sambilbow/Deck-X/Deck_X/STL_files/Headgear/BoboVR_Headgear_Adaptor/README.md

# BoboVR Headgear Adaptor 
These allow for the use of the BoboVR M2 headgear with the Deck X. 

Designed and shared by Noah Zerkin:
> Adapters for a relatively inexpensive Bobo clone / derivative. Had to cut and grind down the slide receivers on that headgear. Want to make one more tweak tomorrow and will post. Ergonomics aren’t bad, even without the foam forehead pad that’s missing from this one. Adjustability isn’t as smooth or clever as FLZero’s, but there’s actually a little more of it in terms of vertical repositioning, and slides out at least far enough to accommodate my glasses.

<div align="right"><i>
@noazark, August 2022 | Project North Star Discord Server | <a href="https://discord.com/channels/456107915514871828/456857961344532492/1007685576348151900">#3d-printing</a>
</i></div>

## What to print
`BoboAdapterL.stl`, for the left side, then again but flip on the x-axis for the right side.

## What to buy 
BoboVR M2 Plus (model without the battery) [[Amazon]](https://www.amazon.co.uk/dp/B0B2RP1N4F?psc=1&ref=ppx_yo2ov_dt_b_product_details) [[AliExpress]](https://www.aliexpress.com/item/1005002603950456.html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)

## Assembly
1. Add the hex screws provided with the Deck X kit into the adaptors.
2. Connect the adaptors to each side of the headgear 
3. Tighten the new headgear to the optics bracket via the hex screw
4. Adjust fit using adaptor angle and tightness to bring optics bracket closer to the face.

## Photos

| Images | Description |
:----------:|:-------------:
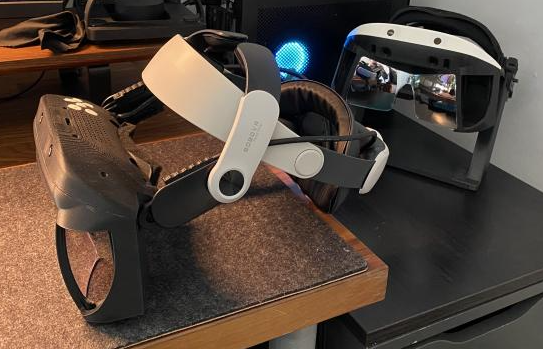
[picture p1: Deck_X/STL_files/Headgear/BoboVR_Headgear_Adaptor/img/bobovr-1.png]
BoboVR Deck X with Bollé Welding Headgear Deck X in the background
 | BoboVR Deck X with <a href="">Bollé Welding Headgear</a> Deck X in the background on an original calibration stand
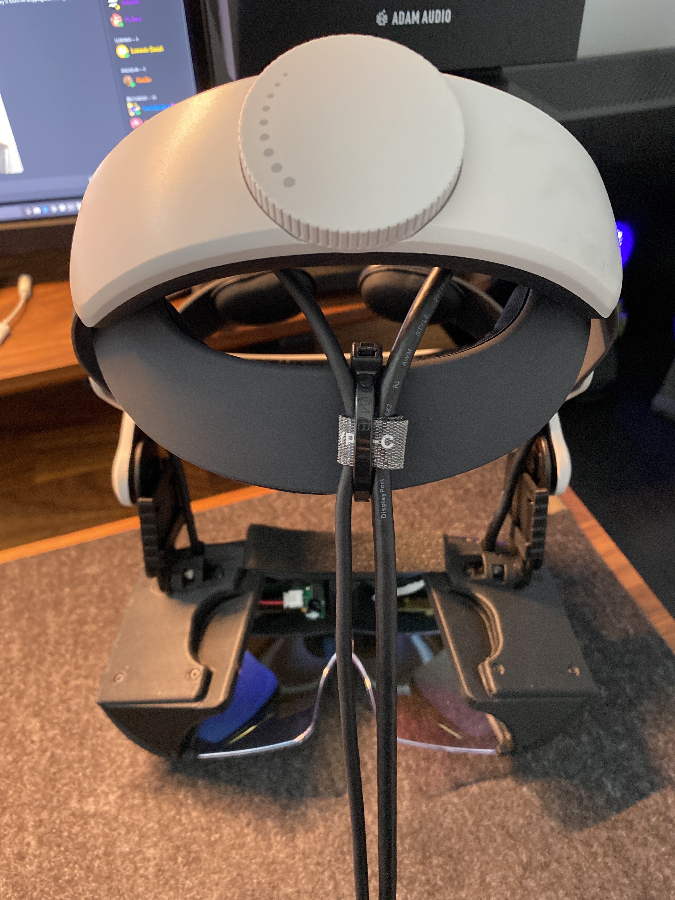
[picture p2: Deck_X/STL_files/Headgear/BoboVR_Headgear_Adaptor/img/bobovr-2.png]
Cable view of the BoboVR with Velcro & zip tie solution
 | Cable view of the BoboVR with Velcro & zip tie solution
