sambilbow/Deck-X/Deck_X/STL_files/Headgear/BoboVR_Headgear_Adaptor/BoboAdapterL.stp

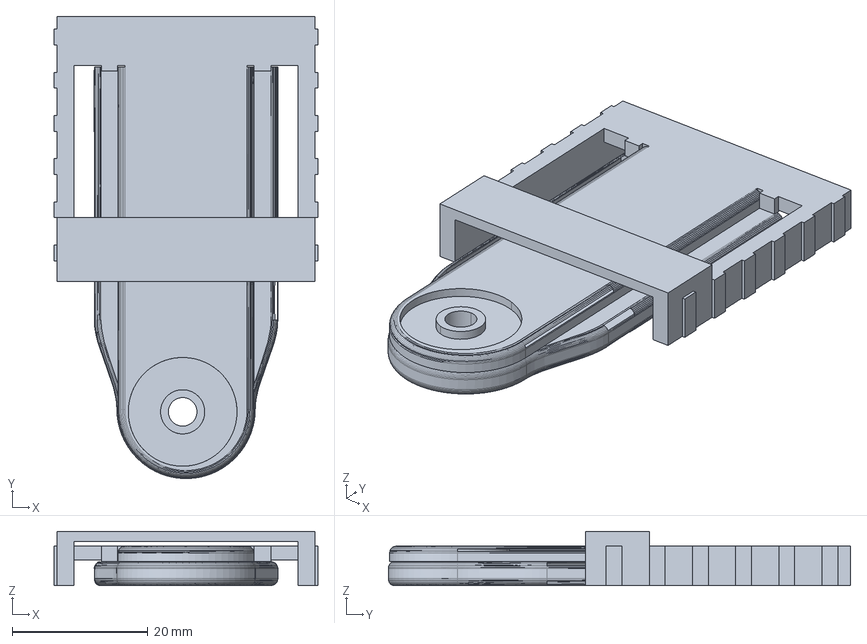
[picture p9: CAD file, 2023-05-10]
Deck_X/STL_files/Headgear/BoboVR_Headgear_Adaptor/BoboAdapterL.stp
38.8 x 68.0 x 7.96 mm
