sambilbow/Deck-X/Deck_X/STL_files/Headgear/Welding_Headgear_Adaptor/headgear_rail_attachment.stl

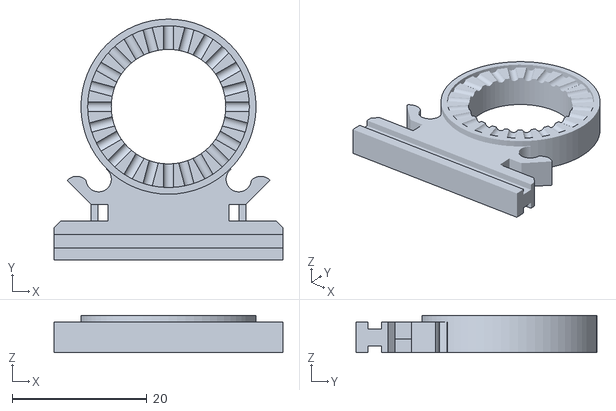
[picture p10: CAD file, 2021-10-27]
Deck_X/STL_files/Headgear/Welding_Headgear_Adaptor/headgear_rail_attachment.stl
34.0 x 35.8 x 5.50
