sambilbow/Deck-X/Deck_X/STL_files/Headgear/Welding_Headgear_Adaptor/headgear_spacer.stl

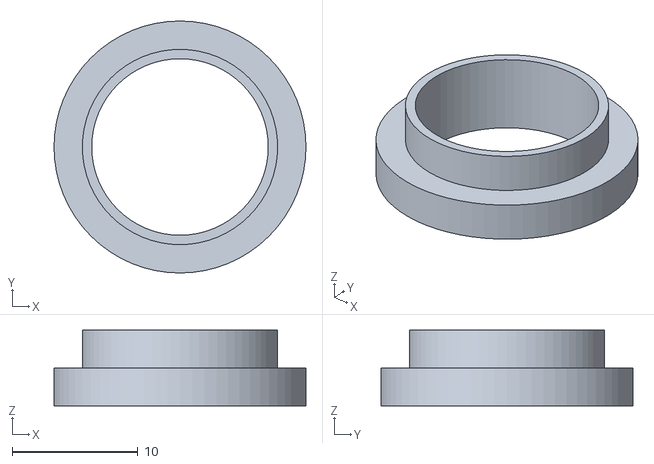
[picture p11: CAD file, 2021-10-27]
Deck_X/STL_files/Headgear/Welding_Headgear_Adaptor/headgear_spacer.stl
20.0 x 20.0 x 6.00
