sambilbow/Deck-X/Deck_X/STL_files/Headgear/Welding_Headgear_Adaptor/headgear_mount_L.stl

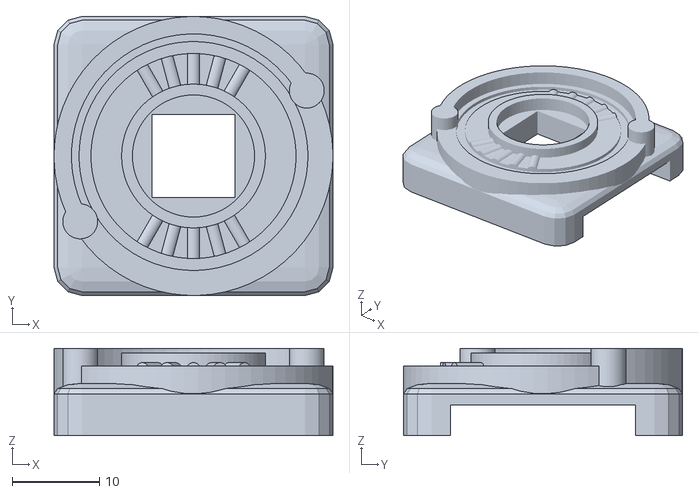
[picture p12: CAD file, 2021-10-27]
Deck_X/STL_files/Headgear/Welding_Headgear_Adaptor/headgear_mount_L.stl
32.0 x 32.0 x 10.0
