sambilbow/Deck-X/Deck_X/STL_files/Headgear/Welding_Headgear_Adaptor/headgear_brake_housing_L.stl

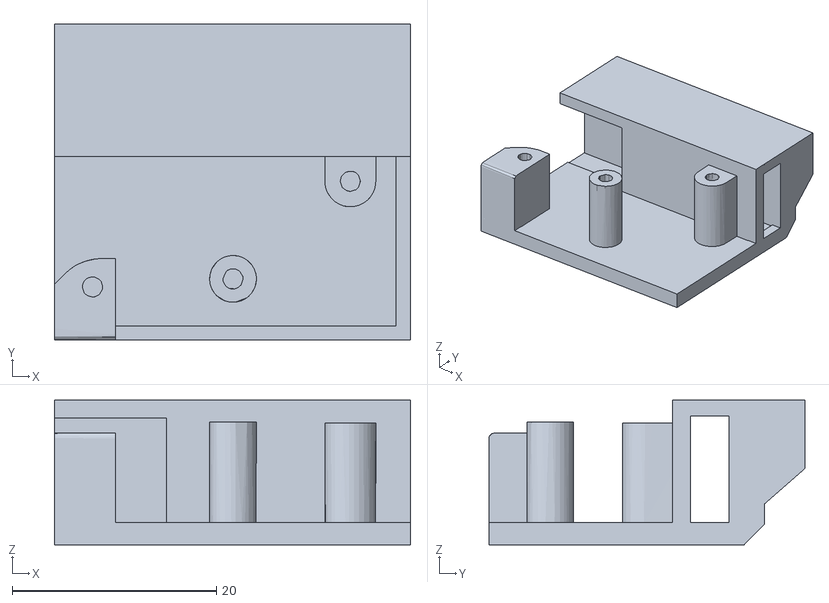
[picture p13: CAD file, 2021-10-27]
Deck_X/STL_files/Headgear/Welding_Headgear_Adaptor/headgear_brake_housing_L.stl
34.9 x 31.0 x 14.2
