sambilbow/Deck-X/Deck_X/STL_files/Headgear/Welding_Headgear_Adaptor/headgear_brake_cover_L.stl

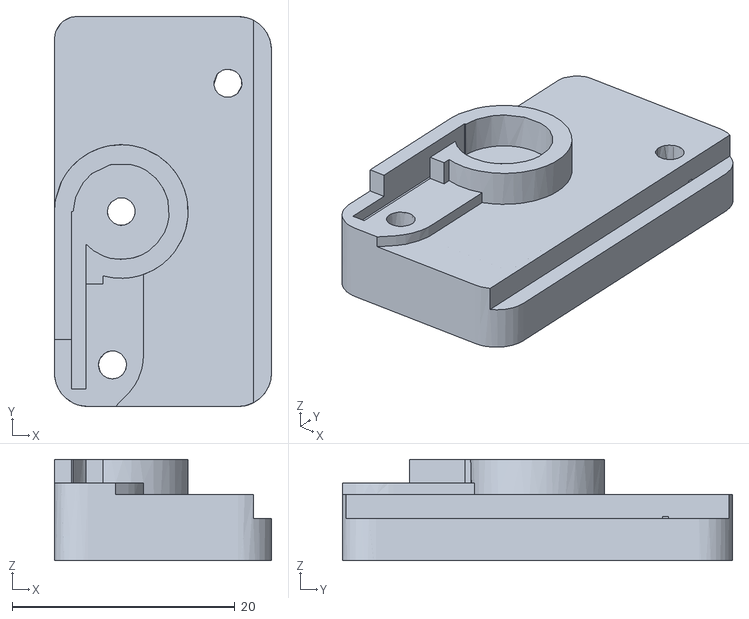
[picture p14: CAD file, 2021-10-27]
Deck_X/STL_files/Headgear/Welding_Headgear_Adaptor/headgear_brake_cover_L.stl
19.5 x 35.0 x 9.11
