sambilbow/Deck-X/(list of files, cad)

Other CAD files:
Deck_X/STL_files/Headgear/BoboVR_Headgear_Adaptor/BoboAdapterL.stl
