sambilbow/Deck-X/(commit log)

2021-10-27 Add welding headgear pieces
    Credit: https://www.tinkercad.com/users/fUWeOPRZm6J-juraj-vincur.
    [headgear_brake_cover_L.stl, headgear_brake_housing_L.stl, headgear_mount_L.stl, headgear_rail_attachment.stl, headgear_spacer.stl]
2022-10-12 Update README.md with explanation video and assembly images
2023-05-10 :sparkles: (headgear) Add Noah's BoboVR headgear adaptor
    [BoboAdapterL.stl, BoboAdapterL.stp]
